nodevuser197/astobot-logic/logic.kicad_pcb

## KiCad design logic.kicad_pcb (2026-07-08)

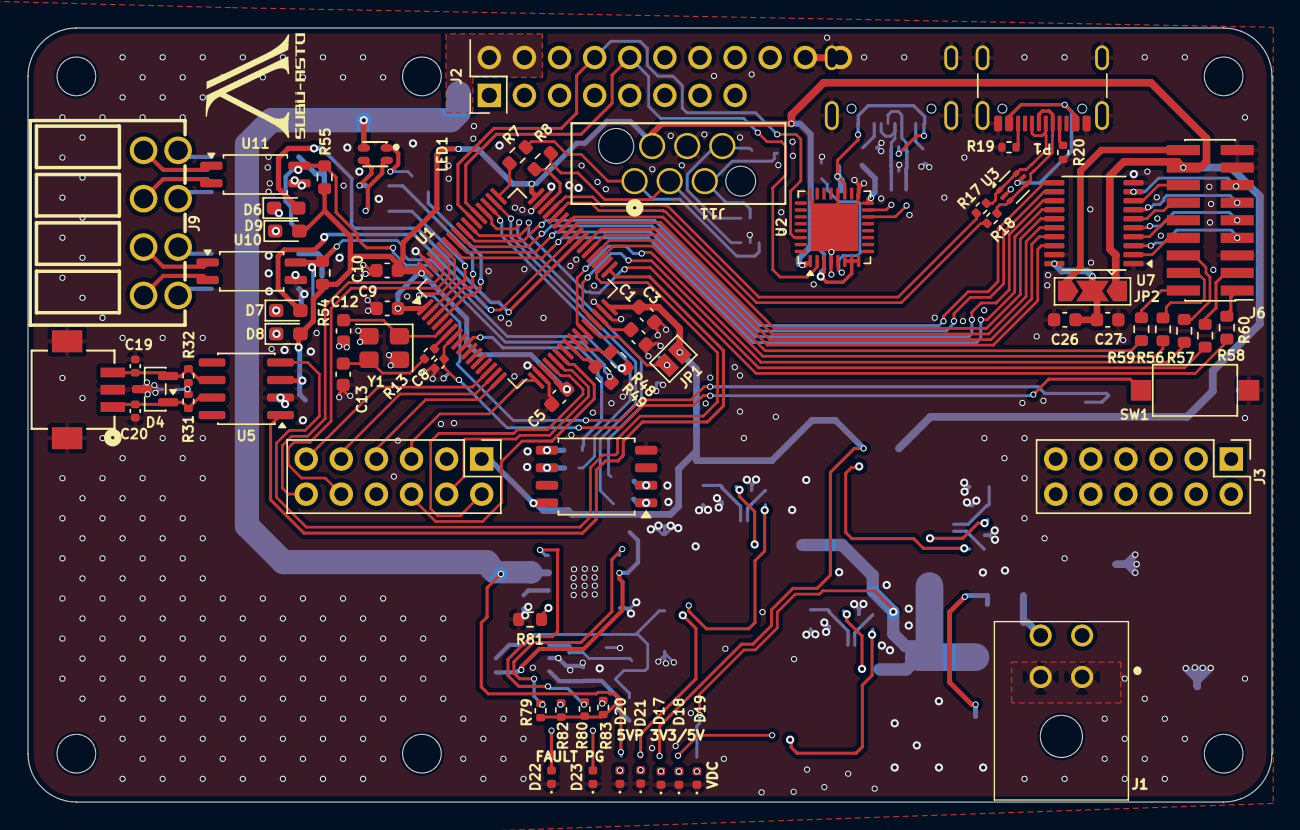
[picture p1: board logic.kicad_pcb from above]

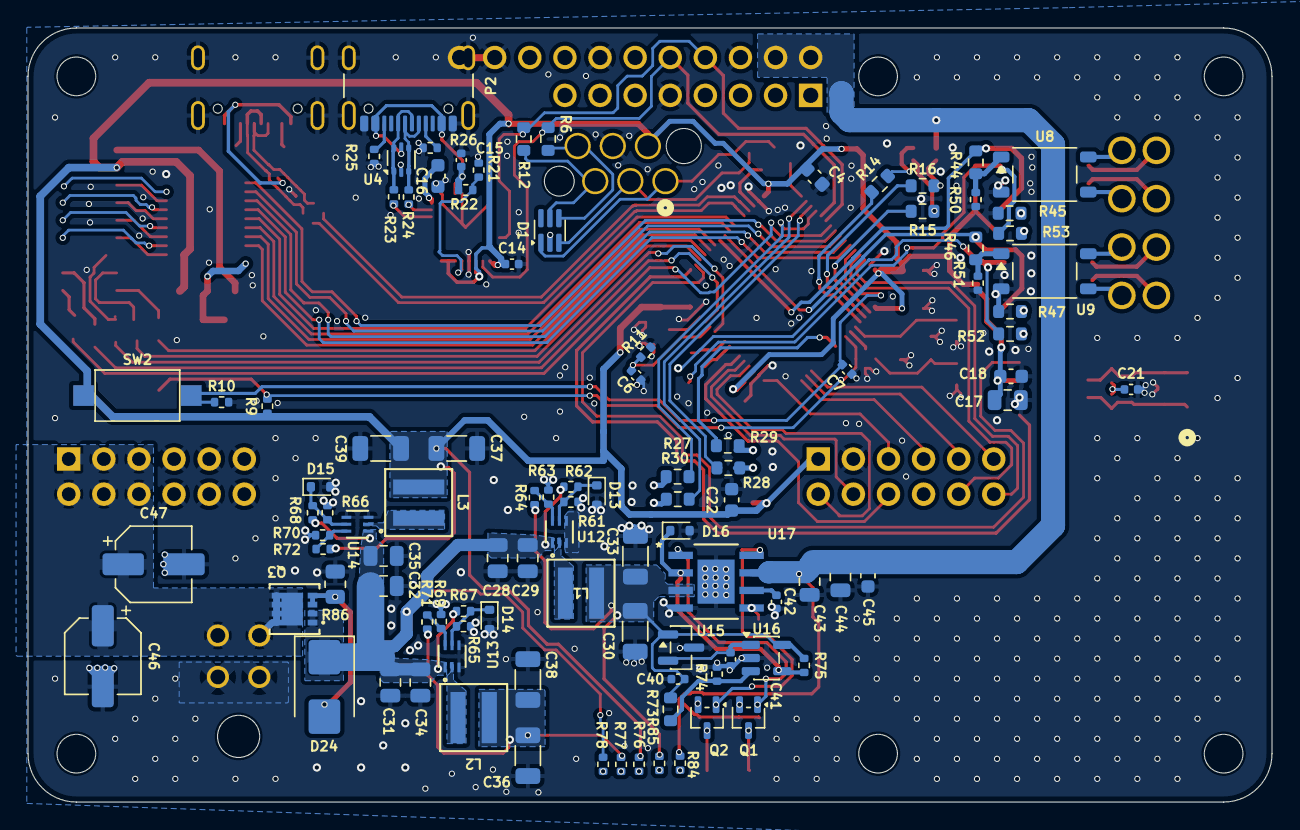
[picture p2: board logic.kicad_pcb from below]

Board: 2 copper layers, 90.0 x 56.0 mm, 169 parts (100 on the bottom side), 140 nets.

Parts:
C1, C3, C4, C10: 2u2; C_0603_1608Metric
C5, C9, C18, C26: u1; C_0603_1608Metric
C6, C7, C8, C15, C40, C41: u1; C_0402_1005Metric
C12, C13: 15p; C_0603_1608Metric
C14: 1u; C_0402_1005Metric
C16, C22, C27: 1u; C_0603_1608Metric
C17: 2.2u; C_0805_2012Metric
C19, C20: 47p; C_0402_1005Metric
C21: 2u2; C_0402_1005Metric
C28, C31, C32: 15u; C_0805_2012Metric
C29, C34, C35: 6.8u; C_0805_2012Metric
C30, C33, C36, C37, C38, C39: 33u; C_1206_3216Metric
C42: 22n; C_0402_1005Metric
C43, C44: 4u7; C_0805_2012Metric
C45: u22; C_0603_1608Metric
C46: 10u; CP_Elec_5x5.4
C47: 22u; CP_Elec_5x5.4
D1: SP0504BAHT; SOT-363_SC-70-6
D4: TVS-DUAL; SOT-23
D6, D7, D8, D9: Red; LED_0603_1608Metric_Pad1.05x0.95mm_HandSolder
D13, D14, D15: 5.1; D_SOD-523
D16: 5.1V; D_SOD-523
D17, D18: BLUE; LED_0402_1005Metric
D19, D20, D22: RED; LED_0402_1005Metric
D21, D23: GREEN; LED_0402_1005Metric
D24: SMBJ26; D_SMB
J1: CN; 66200421022
J2: Raspberry_Pi_4; PinHeader_2x20_P2.54mm_Vertical
J3: PWR; PinHeader_2x06_P2.54mm_Vertical
J4: Logic; PinHeader_2x06_P2.54mm_Vertical
J5: Conn_01x03; DF13A-3P-1-25H-21-
J6: Conn_02x09_Odd_Even; PinHeader_2x09_P1.27mm_Vertical_SMD
J9: ISI/O; JL15EDGRHC-35004B02
J11: Debug; CONN6_490107670612_WRE
JP1: SJ; SolderJumper-2_P1.3mm_Open_Pad1.0x1.5mm
JP2: SJ; SolderJumper-3_P2.0mm_Open_TrianglePad1.0x1.5mm
L1, L2, L3: 3.3u; IND_EXLA-0402_EAT
LED1: LTST-C19HE1WT_C458749; LTST-C19HE1WT
P1, P2: USB_C_Plug_USB2.0; USB_C_Receptacle_GCT_USB4105-xx-A_16P_TopMnt_Horizontal
Q1, Q2: MMBTA94; SOT-323_SC-70
Q3: DMP2008UFG-7; DMP2008UFG-7_DIO
R6, R7, R8, R12, R27, R28, R29, R30, R48, R49, R56, R57, R58, R59, R60: 33; R_0603_1608Metric
R9, R10, R11, R22, R50, R51, R74, R75, R79, R80: 10k; R_0402_1005Metric
R13: 0; R_0402_1005Metric
R14: 330; R_0603_1608Metric
R15, R16: 180; R_0603_1608Metric
R17, R18, R23, R24: 15; R_0402_1005Metric
R19, R20, R25, R26: 5.1k; R_0402_1005Metric
R21: 15k; R_0402_1005Metric
R31, R32: 60; R_0402_1005Metric
R44, R46: 220; R_0603_1608Metric
R45, R47, R52, R53: 670; R_0603_1608Metric
R54, R55: 10k; R_0603_1608Metric
R61, R63, R65, R66, R69, R70: 30k; R_0402_1005Metric
R62, R67, R68: 20k; R_0402_1005Metric
R64, R71, R72: 220k; R_0402_1005Metric
R73: 10.5k; R_0603_1608Metric
R76, R77, R78, R82, R83, R84, R85: 2k2; R_0402_1005Metric
R81: 91; R_0603_1608Metric
R86: 68k; R_0805_2012Metric
SW1, SW2: SW_SPST; SW_SPST_CK_RS282G05A3
U1: STM32F446RCTx; LQFP-64_10x10mm_P0.5mm
U2: CY7C65213-32LTXI; QFN-32-1EP_5x5mm_P0.5mm_EP3.45x3.45mm
U3, U4: USBLC6-2P6; SOT-666
U5: SN65HVD232; SOIC-8_3.9x4.9mm_P1.27mm
U6: W25Q16JVSS; SOIC-8_5.3x5.3mm_P1.27mm
U7: 74AHC541; TSSOP-20_4.4x6.5mm_P0.65mm
U8, U9: TLP175A; Toshiba_SOIC-4-6_4.4x3.6mm_P1.27mm
U10, U11: FODM217A; SOP-4_4.4x2.6mm_P1.27mm
U12, U13, U14: TPS565247DRLR; SOT5X3-6_DRL_TEX
U15: REF3025; SOT-23
U16: LM397; SOT-23-5
U17: TPS2421-1DDA; DDA8_3P2X2P69
Y1: 12MHz; Crystal_SMD_3225-4Pin_3.2x2.5mm

Connections:
+3V3: C3.1, C4.1, C5.1, C9.1, C10.1, C14.1, C17.1, C18.1, C22.1, C37.1, C39.1, D8.2 (A), D9.2 (A), J4.1, J6.16, J11.2 (+12V), JP1.2 (B), JP2.1 (A), L3.1, R9.1, R54.1, R55.1, R72.2, R76.2, SW2.1 (A), U1.1 (VBAT), U1.19 (VDD), U1.32 (VDD), U1.48 (VDD), U1.64 (VDD), U2.1 (VCCIO), U2.3 (RI), U2.6 (DSR), U2.7 (DCD), U2.8 (CTS), U5.3 (VCC), U6.8 (VCC)
+5V: C36.1, C38.1, J6.18, JP2.3 (B), L2.1, R71.2, R77.2
+5VP: C30.1, C33.1, C40.1, L1.1, R64.2, R73.1, R75.1, R85.1, U15.1 (IN), U16.5 (V+), U17.3 (VIN)
+BATT: C46.1, C47.1, J1.3, J1.4, J3.1, J3.2, J3.3, J3.4, J3.5, J3.6, Q3.5, Q3.6, Q3.7, Q3.8
/1A: J6.8, U7.2 (A0)
/1B: J6.12, U7.6 (A4)
/2A: J6.7, U7.3 (A1)
/2B: J6.11, U7.7 (A5)
/3A: J6.10, U7.4 (A2)
/3B: J6.14, U7.8 (A6)
/4A: J6.9, U7.5 (A3)
/4B: J6.13, U7.9 (A7)
/CLK: J6.3, R58.2
/I2C.DATA: J6.1, R60.2
/Isolated IO/INCH1: J9.3, U8.4
/Isolated IO/INCH2: J9.7, U9.4
/Isolated IO/IsolatedInput1/POUT: R49.2, R53.2, R55.2, U11.4
/Isolated IO/IsolatedInput/POUT: R48.2, R52.2, R54.2, U10.4
/Isolated IO/IsolatedOutput1/PIN: R46.2, R51.1, U9.1
/Isolated IO/IsolatedOutput/PIN: R44.2, R50.1, U8.1
/Isolated IO/OUTCH1: J9.1, U8.6
/Isolated IO/OUTCH2: J9.5, U9.6
/Isolated IO/PCH1: J9.6, U10.1
/Isolated IO/PCH2: J9.2, U11.1
/Isolated IO/REFCH1: J9.8, U10.2
/Isolated IO/REFCH2: J9.4, U11.2
/Periphals/CANH: C20.1, D4.1 (K1), J5.1, R31.2, U5.7 (CANH)
/Periphals/CANL: C19.1, D4.2 (K2), J5.3, R32.1, U5.6 (CANL)
/Periphals/DN: R24.1, U2.15 (USBDM)
/Periphals/DP: R23.1, U2.14 (USBDP)
/Periphals/_DN: P2.A7 (D-), P2.B7 (D-), R24.2, U4.3 (I/O2), U4.4 (I/O2)
/Periphals/_DP: P2.A6 (D+), P2.B6 (D+), R23.2, U4.1 (I/O1), U4.6 (I/O1)
/Periphals/uDN: P1.A7 (D-), P1.B7 (D-), R18.2, U3.3 (I/O2), U3.4 (I/O2)
/Periphals/uDP: P1.A6 (D+), P1.B6 (D+), R17.2, U3.1 (I/O1), U3.6 (I/O1)
/Power/~FAULT: Q1.1 (B), R79.2, U17.1 (~FLT)
/Power/~PG: Q2.1 (B), R80.2, U17.8 (~PG)
/SPI.CS: J6.6, R57.2
/SPI.SI: J6.2, R59.2
/SPI.SO: J6.4, R56.2
/uC/BOOT0: C7.1, R10.1, SW2.2 (B), U1.60 (BOOT0)
/uC/BOOT1: C6.1, JP1.1 (A), R11.1, U1.28 (PB2)
/uC/CAN.RX: U1.33 (PB12), U5.1 (D)
/uC/CAN.TX: U1.34 (PB13), U5.4 (R)
/uC/HSE_IN: C12.1, U1.5 (PH0), Y1.1
/uC/HSE_OUT: R13.1, U1.6 (PH1)
/uC/I2C1.CK: J4.12, U1.62 (PB9)
/uC/I2C1.SD: J4.10, U1.61 (PB8)
/uC/I2C2.CK: R58.1, U1.29 (PB10)
/uC/I2C2.SD: R60.1, U1.55 (PB3)
/uC/IO1: R15.2, U1.2 (PC13)
/uC/IO2: R16.2, U1.3 (PC14)
/uC/IO3: R14.2, U1.4 (PC15)
/uC/ISI1: R48.1, U1.25 (PC5)
/uC/ISI2: R49.1, U1.24 (PC4)
/uC/ISO1: D6.2 (A), R44.1, U1.39 (PC8)
/uC/ISO2: D7.2 (A), R46.1, U1.40 (PC9)
/uC/MC.CK: J4.4, U1.21 (PA5)
/uC/MC.CS: J4.2, U1.20 (PA4)
/uC/MC.SI: J4.6, U1.22 (PA6)
/uC/MC.SO: J4.8, U1.23 (PA7)
/uC/MCP1: J4.11, U1.14 (PA0)
/uC/MCP2: J4.9, U1.15 (PA1)
/uC/MCP3: J4.7, U1.16 (PA2)
/uC/MCP4: J4.5, U1.17 (PA3)
/uC/NRST: C8.1, R9.2, SW1.1 (A), U1.7 (NRST)
/uC/QEA1: U1.41 (PA8), U7.16 (Y2)
/uC/QEA2: U1.56 (PB4), U7.11 (Y7)
/uC/QEA3: U1.58 (PB6), U7.13 (Y5)
/uC/QEA4: U1.37 (PC6), U7.18 (Y0)
/uC/QEB1: U1.42 (PA9), U7.15 (Y3)
/uC/QEB2: U1.57 (PB5), U7.12 (Y6)
/uC/QEB3: U1.59 (PB7), U7.14 (Y4)
/uC/QEB4: U1.38 (PC7), U7.17 (Y1)
/uC/SI2.CS: R57.1, U1.27 (PB1)
/uC/SI2.SI: R59.1, U1.36 (PB15)
/uC/SI2.SO: R56.1, U1.35 (PB14)
/uC/SI3.CK: R28.1, U1.51 (PC10)
/uC/SI3.CS: R27.1, U1.50 (PA15)
/uC/SI3.SI: R29.1, U1.9 (PC1)
/uC/SI3.SO: R30.1, U1.52 (PC11)
/uC/SWD.CK: R7.1, U1.49 (PA14)
/uC/SWD.IO: R8.1, U1.46 (PA13)
/uC/UART.RX: J2.8 (GPIO14/UART_TXD), R12.1, U1.54 (PD2), U2.30 (TXD)
/uC/UART.TX: J2.10 (GPIO15/UART_RXD), R6.2, U1.53 (PC12), U2.2 (RXD)
/uC/USB.DN: R18.1, U1.44 (PA11)
/uC/USB.DP: R17.1, U1.45 (PA12)
GND: C1.2, C3.2, C4.2, C5.2, C6.2, C7.2, C8.2, C9.2, C10.2, C12.2, C13.2, C14.2, C15.2, C16.2, C17.2, C18.2, C19.2, C20.2, C21.2, C22.2, C26.2, C27.2, C28.2, C29.2, C30.2, C31.2, C32.2, C33.2, C34.2, C35.2, C36.2, C37.2, C38.2, C39.2, C40.2, C41.2, C42.2, C43.2, C44.2, C45.2, C46.2, C47.2, D1.2 (A), D4.3 (A), D13.2 (A), D14.2 (A), D15.2 (A), D16.2 (A), D17.1 (K), D18.1 (K), D19.1 (K), D20.1 (K), D21.1 (K), D22.1 (K), D23.1 (K), J1.1, J1.2, J2.6 (GND), J2.9 (GND), J2.14 (GND), J2.20 (GND), J3.7, J3.8, J3.9, J3.10, J3.11, J3.12, J4.3, J5.2, J6.5, J6.15, J6.17, J11.4 (GND), P1.A1 (GND), P1.A12 (GND), P1.B1 (GND), P1.B12 (GND), P1.S1 (SHIELD), P2.A1 (GND), P2.A12 (GND), P2.B1 (GND), P2.B12 (GND), P2.S1 (SHIELD), R10.2, R11.2, R19.2, R20.2, R21.2, R25.2, R26.2, R45.2, R47.2, R50.2, R51.2, R61.2, R63.1, R65.2, R66.2, R69.1, R70.1, R74.2, R81.2, R86.2, SW1.2 (B), U1.18 (VSS), U1.31 (VSS), U1.47 (VSS), U1.63 (VSS), U2.4 (GND), U2.17 (GND), U2.20 (GND), U2.24 (AGND), U2.33 (1EP), U3.2 (GND), U4.2 (GND), U5.2 (GND), U6.4 (GND), U7.1 (G1), U7.10 (GND), U7.19 (G2), U8.3, U9.3, U10.3, U11.3, U12.3 (GND), U12.4 (AGND), U13.3 (GND), U13.4 (AGND), U14.3 (GND), U14.4 (AGND), U15.3 (GND), U16.2 (V-), U17.4 (GND), U17.EPAD, Y1.2, Y1.4
HL5V: C43.1, C44.1, C45.1, J2.2 (5V), J2.4 (5V), LED1.4 (+), R79.1, R80.1, R82.1, R83.2, R84.2, U17.7 (VOUT)
unnamed: C13.1, R13.2, Y1.3
unnamed: C21.1, R31.1, R32.2
unnamed: D1.1 (K), J11.1 (+12V), R7.2
unnamed: D1.3 (K), J11.3 (GND), R8.2
unnamed: D1.4 (K), J11.6 (GND), R6.1
unnamed: D1.5 (K), J11.5 (GND), R12.2
unnamed: D6.1 (K), R45.1
unnamed: D7.1 (K), R47.1
unnamed: D8.1 (K), R52.1
unnamed: D9.1 (K), R53.1
unnamed: D13.1 (K), R61.1, R62.2, U12.5 (EN)
unnamed: D14.1 (K), R65.1, R67.2, U13.5 (EN)
unnamed: D15.1 (K), R66.1, R68.2, U14.5 (EN)
unnamed: D16.1 (K), R75.2, U16.4, U17.2 (~EN)
unnamed: D17.2 (A), R76.1
unnamed: D18.2 (A), R77.1
unnamed: D19.2 (A), R78.2
unnamed: D20.2 (A), R84.1
unnamed: D21.2 (A), R85.2
unnamed: D22.2 (A), Q1.3 (C)
unnamed: D23.2 (A), Q2.3 (C)
unnamed: D24.2 (A), Q3.3, Q3.4, R86.1
unnamed: C26.1, C27.1, JP2.2 (C), U7.20 (VCC)
unnamed: LED1.3 (B-), R16.1
unnamed: LED1.2 (G-), R15.1
unnamed: LED1.1 (R-), R14.1
unnamed: P1.A5 (CC), R20.1
unnamed: P1.B5 (VCONN), R19.1
unnamed: P2.A5 (CC), R26.1
unnamed: P2.B5 (VCONN), R25.1
unnamed: Q1.2 (E), R82.2
unnamed: Q2.2 (E), R83.1
unnamed: C1.1, U1.30 (VCAP_1)
unnamed: R21.1, R22.1, U2.5 (GPIO5)
unnamed: C16.1, U2.16 (VCCD)
unnamed: R28.2, U6.6 (CLK)
unnamed: R29.2, U6.5 (DI/IO_{0})
unnamed: R30.2, U6.2 (DO/IO_{1})
unnamed: R27.2, U6.1 (~CS)
unnamed: R63.2, R64.1, U12.6 (FB)
unnamed: L1.2, U12.2 (SW)
unnamed: R69.2, R71.1, U13.6 (FB)
unnamed: L2.2, U13.2 (SW)
unnamed: R70.2, R72.1, U14.6 (FB)
unnamed: L3.2, U14.2 (SW)
unnamed: C41.1, U15.2 (OUT), U16.1 (-)
unnamed: R73.2, R74.1, U16.3 (+)
unnamed: C42.1, U17.6 (CT)
unnamed: R81.1, U17.5 (ISET)
VBUS1: P1.A4 (VBUS), P1.A9 (VBUS), P1.B4 (VBUS), P1.B9 (VBUS), U3.5 (VBUS)
VBUS2: C15.1, P2.A4 (VBUS), P2.A9 (VBUS), P2.B4 (VBUS), P2.B9 (VBUS), R22.2, U2.19 (VCC), U4.5 (VBUS)
VDC: C28.1, C29.1, C31.1, C32.1, C34.1, C35.1, D24.1 (K), Q3.1, Q3.2, R62.1, R67.1, R68.1, R78.1, U12.1 (VIN), U13.1 (VIN), U14.1 (VIN)
