nodevuser197/astobot-logic/(commit log)

2026-07-08 logic board initial import
2026-11-01 Add handover notes (devir.md) with board analysis and research roadmap
    Claude-Session: https://claude.ai/code/session_01VrbJ8YHz1XHf2MjvWUTYkc
